kimhojun0114/classroom-env/results/mic_fft_test.png

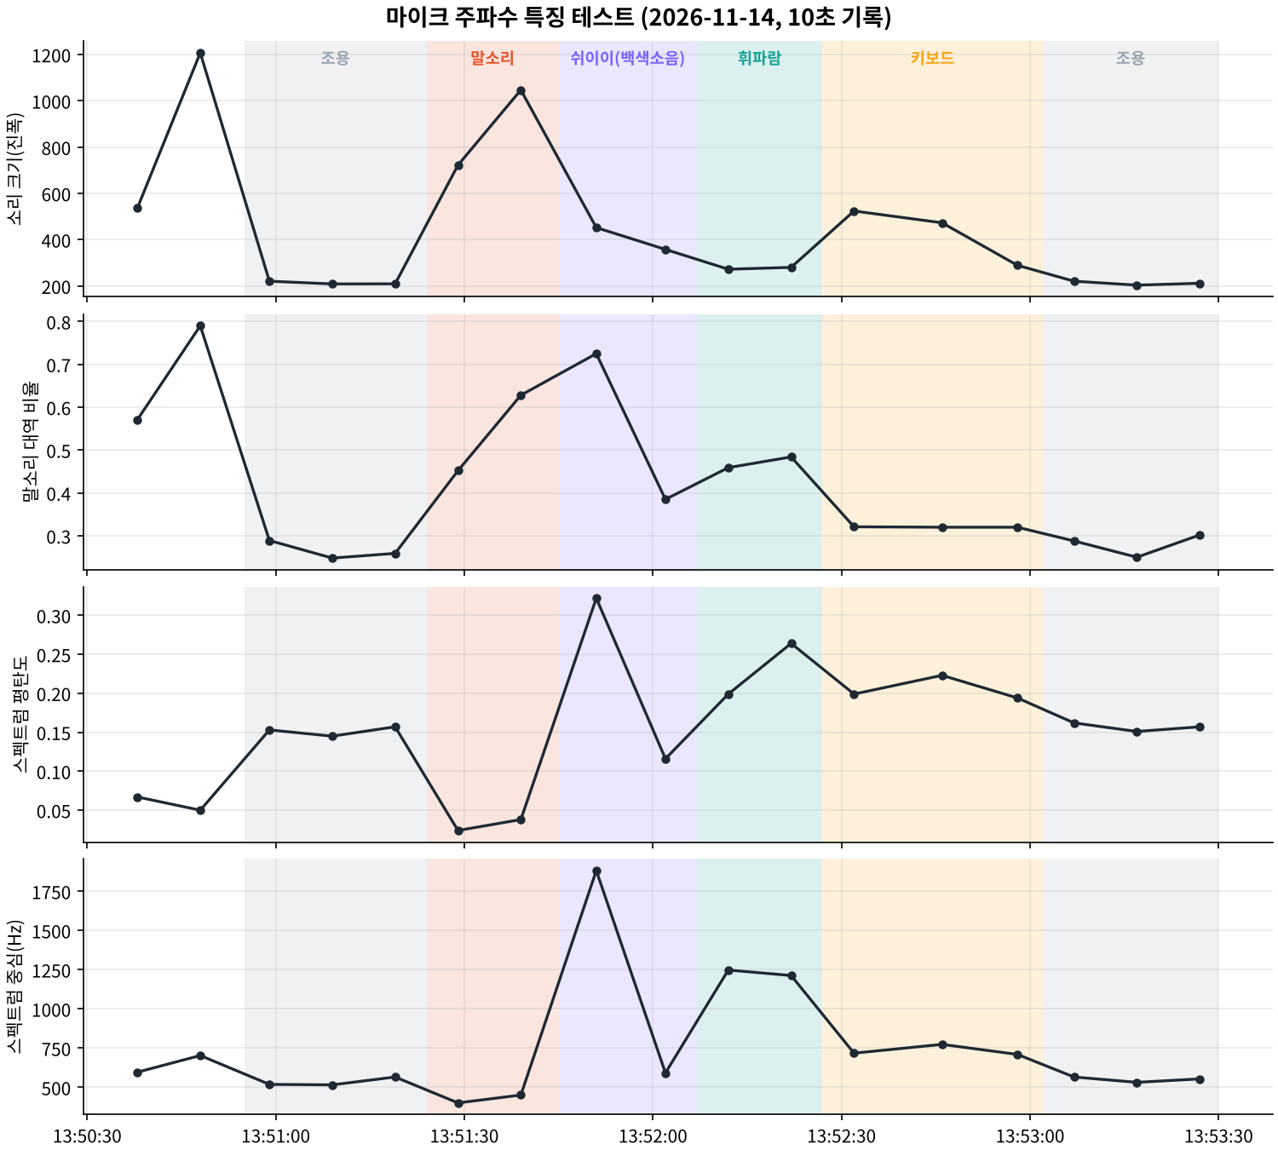
results/mic_fft_test.png
