kimhojun0114/classroom-env/firmware/classroom_env/config.example.h

// config.example.h
// 이 파일을 복사해서 config.h 로 이름을 바꾼 뒤 값을 채우세요.
// config.h 는 .gitignore 에 들어 있어서 깃허브에 올라가지 않습니다(비밀번호 보호).
#pragma once

// ── 와이파이 ─────────────────────────────
// 여러 개를 넣어 두면 신호가 가장 센 곳에 자동 연결됩니다.
// 목록에 없는 곳에서는 끊긴 지 1분 뒤 설정용 와이파이 'ENV-<BOARD_NAME>'이 켜지고,
// 폰/패드로 접속해 그 자리에서 와이파이를 추가할 수 있습니다(장치에 저장, 최대 8개).
#define WIFI_LIST \
  {"학교와이파이", "비밀번호"}, \
  {"집와이파이",   "비밀번호"}
#define BOARD_NAME "main"          // 설정용 와이파이 이름: ENV-main
#define PORTAL_KEY "classenv7"     // 관리 비밀번호 겸 설정용 와이파이 비밀번호 (8자 이상)

// ── Firebase Realtime Database ───────────
// 예: "https://classroom-env-default-rtdb.asia-southeast1.firebasedatabase.app"
// (끝에 / 붙이지 않기)
#define FIREBASE_URL    "https://classroom-env-default-rtdb.asia-southeast1.firebasedatabase.app"
// 프로젝트 설정 > 서비스 계정 > 데이터베이스 비밀번호(Database secrets)
#define FIREBASE_SECRET "YOUR_DATABASE_SECRET"

// ── 센서 선택 ────────────────────────────
// 갖고 있는 SHT 모델: 31 = SHT30/31/35 계열, 40 = SHT40/41/45 계열
#define SHT_MODEL 31

// LCD I2C 주소 (화면이 안 나오면 0x3F 로 바꿔 보기)
#define LCD_ADDR 0x27

// MH-Z19C 자동 보정(ABC) 끄기: 교실은 하루 한 번도 400ppm 바깥 공기 수준까지
// 내려가지 않을 수 있어서, 켜 두면 기준점이 틀어질 수 있음. 1 = 끄기(권장)
#define CO2_ABC_OFF 1

// MH-Z19C 측정 범위(ppm). PWM 값이 UART 값과 크게 다르면 2000 또는 5000으로 바꿔 보기
#define CO2_PWM_RANGE 5000

// 창문 리드 스위치 개수 (0~8). 데이터과학 장치를 합칠 때 사용.
// 핀 순서: 13, 14, 18, 19, 32, 33, 5, 15  (스위치 한쪽은 핀, 다른 쪽은 GND)
#define REED_COUNT 0

// 학습된 인공신경망 사용 여부. tools/export_mlp.py 로 model_weights.h 를 만든 뒤 1로.
#define USE_MLP 0
