kimhojun0114/classroom-env/(commit log)

2026-11-09 교실 학습 환경 조절기 초기 버전: ESP32 펌웨어, 웹앱, 데이터 도구
    Claude-Session: https://claude.ai/code/session_01RUbau35s9DhPUQM7b6cBcN
    [datasci_co2_20261102.csv]
2026-11-09 Firebase 주소 연결
    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
2026-11-12 환기팬 대신 서보모터 창문 모형으로 변경
    - 환기 알림이 켜지면 서보가 창문 모형을 90도로 열고, 해제되면 닫음
    - 웹앱 원격 조절: 창문 모형 자동/열기/닫기
    - 기록 열 fan -> win, README 배선·라이브러리 갱신
    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
2026-11-12 배선도 추가 (docs/wiring.svg, wiring.png)
    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
2026-11-12 실물형 배선도 추가 (docs/wiring_pictorial)
    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
2026-11-12 배선도 새로 정리: SHT3X·BH1750을 보드 I2C 묶음에 직접 연결
    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
2026-11-12 MH-Z19C PWM 출력도 D4로 함께 기록 (UART 값 검증용)
    - 인터럽트로 HIGH/LOW 길이를 재서 CO2 = 범위×(Th−2)/(Th+Tl−4)
    - 기록 열 co2_pwm 추가, CSV 추출·README·배선도 갱신
    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
2026-11-12 리드 스위치 핀에서 D4 제외 (CO2 PWM과 겹침)
    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
2026-11-12 Firebase 업로드 주소 버그 수정 (루트 경로 "/") + 오류 수정 기록
    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
    [classroom_env.ino]
2026-11-12 오류 수정 기록: 빵판 레일 전원 오배선
    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
2026-11-12 소음 판정 개선(100ms 이상 지속된 소리만 급증으로 인정, 기준 15회), LCD 3초마다 2화면 전환·CO2 예열 카운트다운
    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
2026-11-12 판정 기준 완화: 150ms 이상 지속된 소리만 급증, 30초 6회 이상이면 산만·2회 이하면 즉시 해제, 조도 기준 100lx
    웹앱 원격 조절 키를 noise30/luxLow로 변경 (예전 저장값 무시)
    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
    [classroom_env.ino]
2026-11-12 웹앱: 예측 없음(-1)일 때 '약 -1분 뒤' 문구가 뜨던 버그 수정
    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
2026-11-12 소음 판정 실시간화: 0.3초마다 판단, 기준 도달 즉시 빨강, 10초 조용하면 즉시 해제, 상태 바뀌면 LCD 즉시 갱신
    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
2026-11-12 지속 소음 판정 추가: 5초 평균 크기가 loudLvl 이상이면 산만(LOUD), 1초 넘게 이어진 소리는 1초마다 급증 1회 추가, 웹앱에 지속 소음 기준 입력칸
    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
2026-11-12 웹 반영 속도 개선: 웹앱 Firebase 실시간 스트리밍(끊기면 5초 폴링), 상태 바뀌면 장치가 즉시 전송, 원격 설정 10초마다 확인
    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
2026-11-12 웹앱에 CSV 내려받기(센서 기록·라벨, 시작 날짜 선택, 한국 시간, 엑셀 호환 UTF-8 BOM) 추가
    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
2026-11-12 라벨 입력: 선택된 집중도·졸림 버튼을 다시 누르면 선택 해제
    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
2026-11-12 와이파이 여러 개 자동 연결(WiFiMulti) + 끊기면 설정용 와이파이(ENV-main) 포털에서 와이파이 추가·삭제
    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
2026-11-12 웹앱에서 장치 와이파이 추가·삭제(/wifi, 쓰기 키로만 접근), 장치가 1분마다 받아 저장; LCD 와이파이 표시 제거; 규칙 예시에 /wifi 비공개 반영
    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
2026-11-14 소리 주파수 분석 추가: 8kHz 샘플링 + 256점 FFT로 말소리 대역 비율·스펙트럼 평탄도·스펙트럼 중심 계산, 10초 기록·CSV에 snd_sp/snd_flat/snd_cent 저장
    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
2026-11-14 README: 주파수 특징 열 설명 추가
    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
2026-11-14 마이크 주파수 특징 테스트 데이터·그래프 추가 (조용/말소리/백색소음/휘파람/키보드)
    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
